ryanling521/Planar-RRP-Robotic-Manipulator/Pen Sleeve Extender.SLDPRT

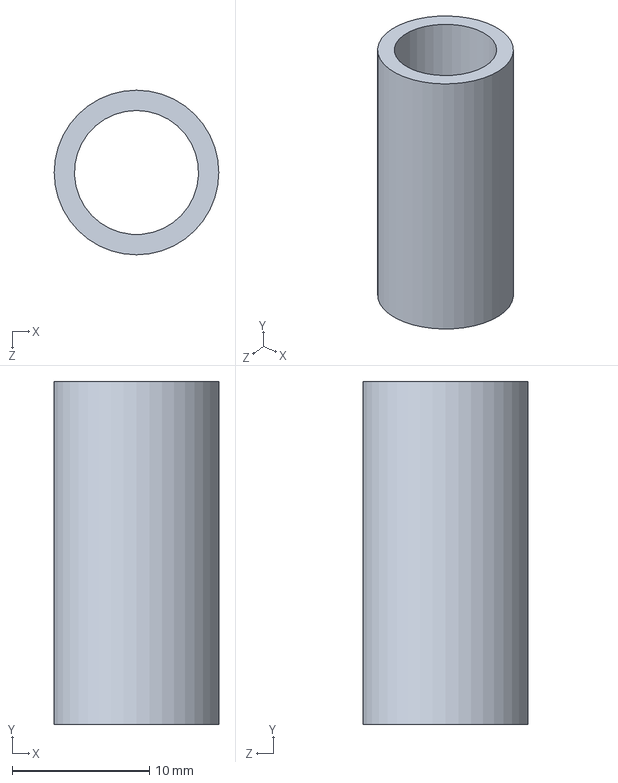
[picture p37: CAD file, 2022-06-14]
Pen Sleeve Extender.SLDPRT
12.0 x 25.0 x 12.0 mm
