ryanling521/Planar-RRP-Robotic-Manipulator/XL-320.step

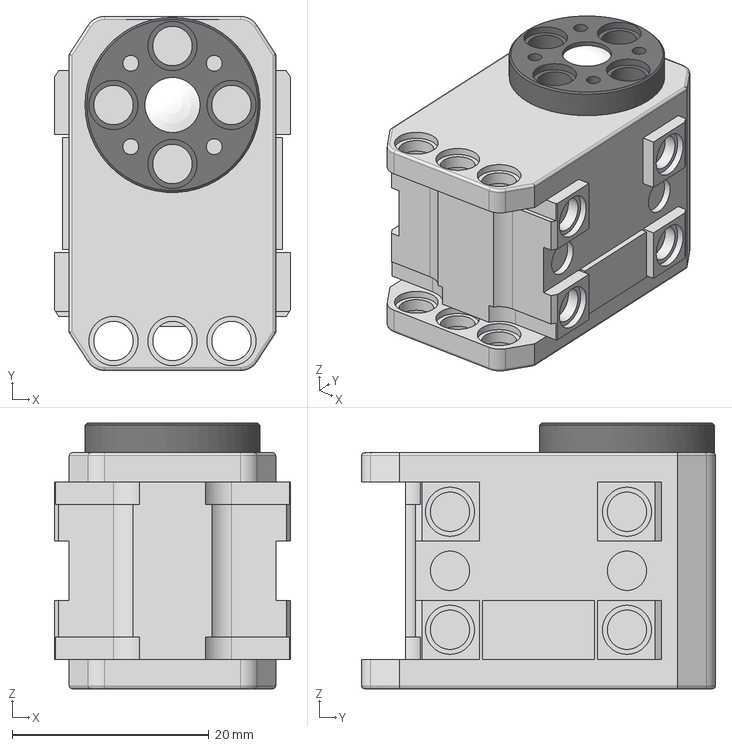
[picture p38: CAD file, 2022-06-14]
XL-320.step
24.0 x 36.0 x 27.0 mm
