ryanling521/Planar-RRP-Robotic-Manipulator/Base_v3.SLDPRT

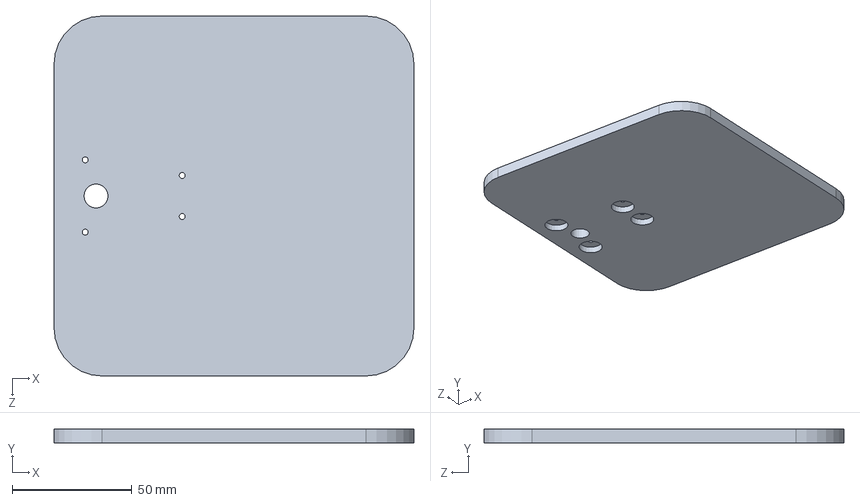
[picture p39: CAD file, 2022-06-14]
Base_v3.SLDPRT
150.0 x 5.80 x 150.0 mm
