ryanling521/Planar-RRP-Robotic-Manipulator/Link1.SLDPRT

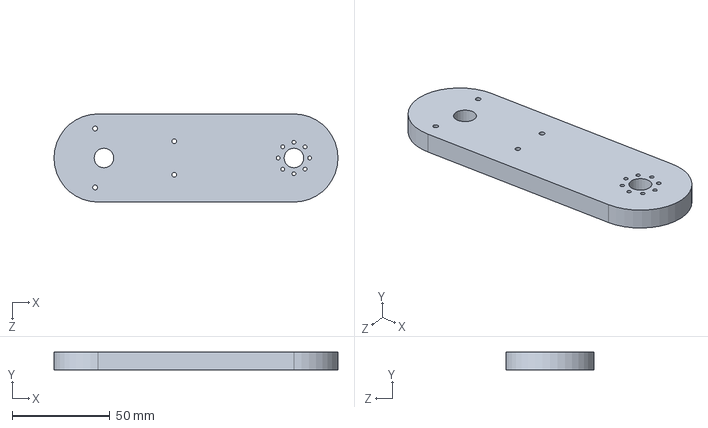
[picture p40: CAD file, 2022-06-14]
Link1.SLDPRT
145.0 x 9.00 x 45.0 mm
