ryanling521/Planar-RRP-Robotic-Manipulator/Pen Sleeve Head.SLDPRT

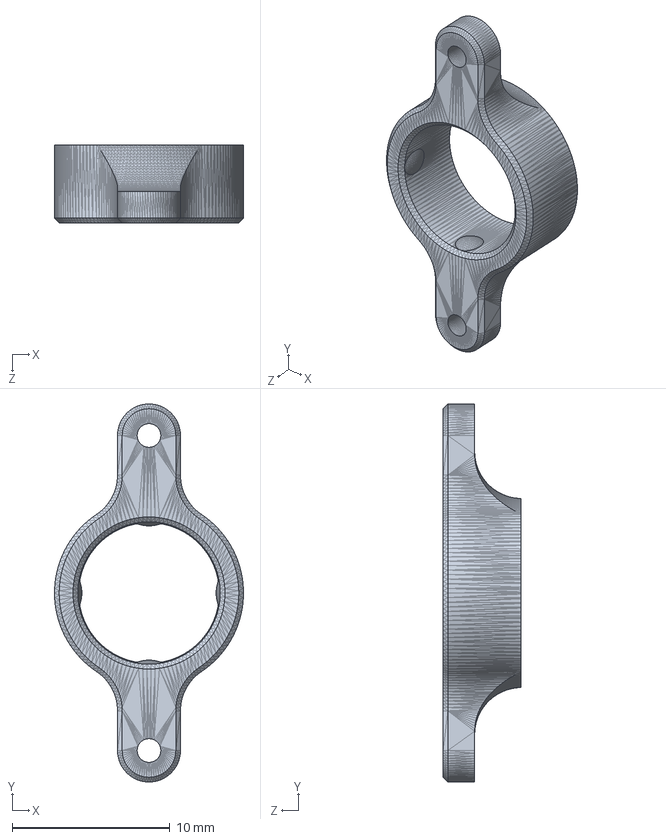
[picture p41: CAD file, 2022-06-14]
Pen Sleeve Head.SLDPRT
12.0 x 24.0 x 4.93 mm
