ryanling521/Planar-RRP-Robotic-Manipulator/Sleeve.SLDPRT

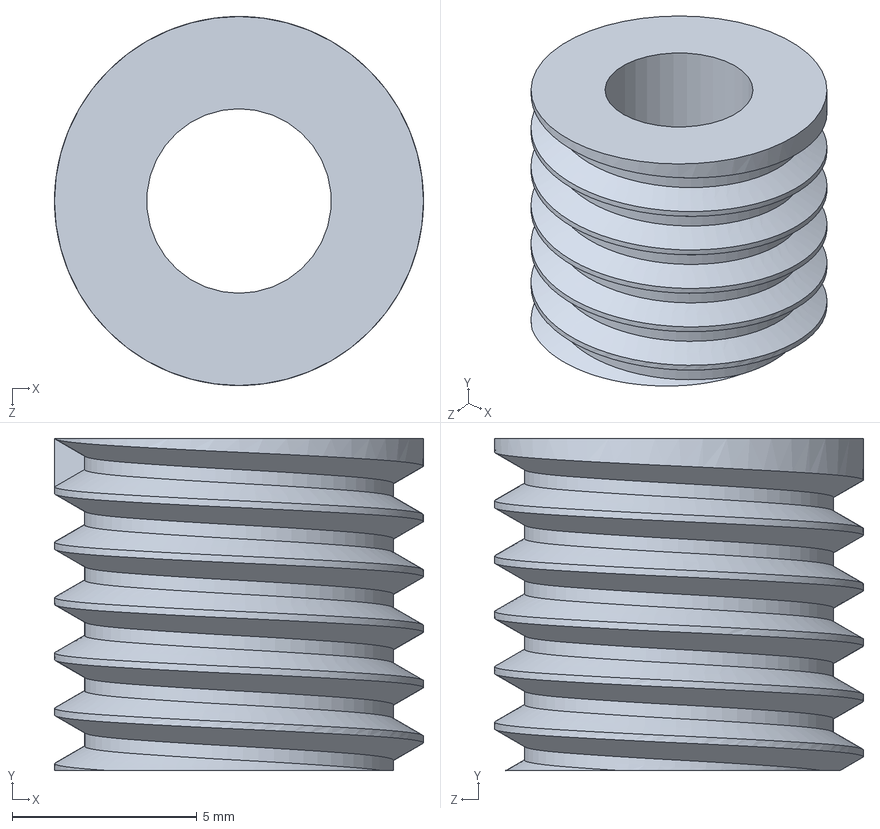
[picture p42: CAD file, 2022-06-14]
Sleeve.SLDPRT
10.0 x 9.00 x 10.0 mm
