ryanling521/Planar-RRP-Robotic-Manipulator/Base.SLDPRT

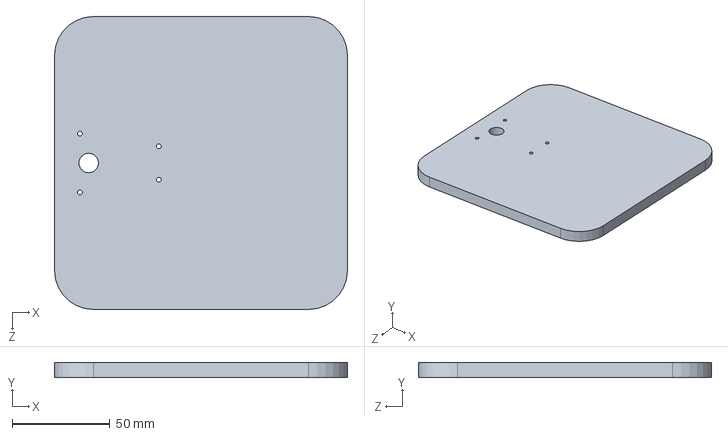
[picture p43: CAD file, 2022-06-14]
Base.SLDPRT
150.0 x 7.50 x 150.0 mm
