ryanling521/Planar-RRP-Robotic-Manipulator/Link1_v2.SLDPRT

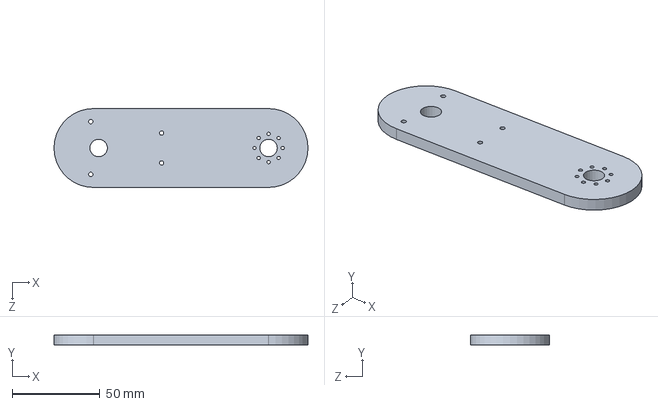
[picture p44: CAD file, 2022-06-14]
Link1_v2.SLDPRT
145.0 x 5.80 x 45.0 mm
