ryanling521/Planar-RRP-Robotic-Manipulator/Link1_OLD.SLDPRT

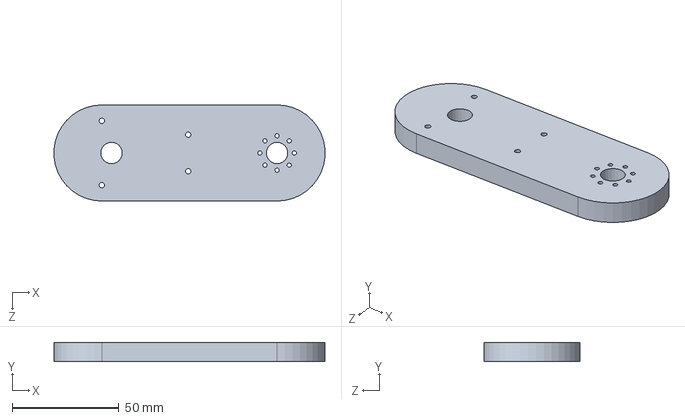
[picture p45: CAD file, 2022-06-14, an earlier design]
Link1_OLD.SLDPRT
126.8 x 9.00 x 45.0 mm
