ryanling521/Planar-RRP-Robotic-Manipulator/(list of files, cad)

Other CAD files:
XL-320.step.SLDPRT
Link2_v2.SLDPRT
Base_v2.SLDPRT
Link2_v1.SLDPRT
